stern-shawn/ShawnAndTianshus-EE-748-Capstone/Android Code/Images/Arm Control/up3.png

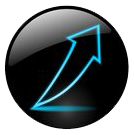
Android Code/Images/Arm Control/up3.png
