stern-shawn/ShawnAndTianshus-EE-748-Capstone/Android Code/Images/voice.png

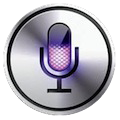
Android Code/Images/voice.png
