stern-shawn/ShawnAndTianshus-EE-748-Capstone/README.md

# ShawnAndTianshus-EE-748-Capstone
Capstone project for EE 478 class. Semi-autonomous robot which could navigate simple mazes, avoid obstacles, grasp objects, and was fully controllable through an android application with additional voice command options over bluetooth
