stern-shawn/ShawnAndTianshus-EE-748-Capstone/Deliverables/Final Project Presentation Slides.pptx

## Mobile Robotic Arm

Tianshu Bao
Shawn Stern
Dan Tran

## The Team – Tianshu Bao

- Major in EE, Embedded System and VLSI
- Previous Hardware Testing Engineer at Cisco
- Software Developer at Expedia
- Traveler

## The Team – Shawn Stern

- Major in EE, Embedded concentration
- Minor in Technical/Business Japanese
- Previously interned at Intel in Santa Clara
- Working full-time at Intel (Aloha, OR) starting July as a PDE
- Part-time head smasher

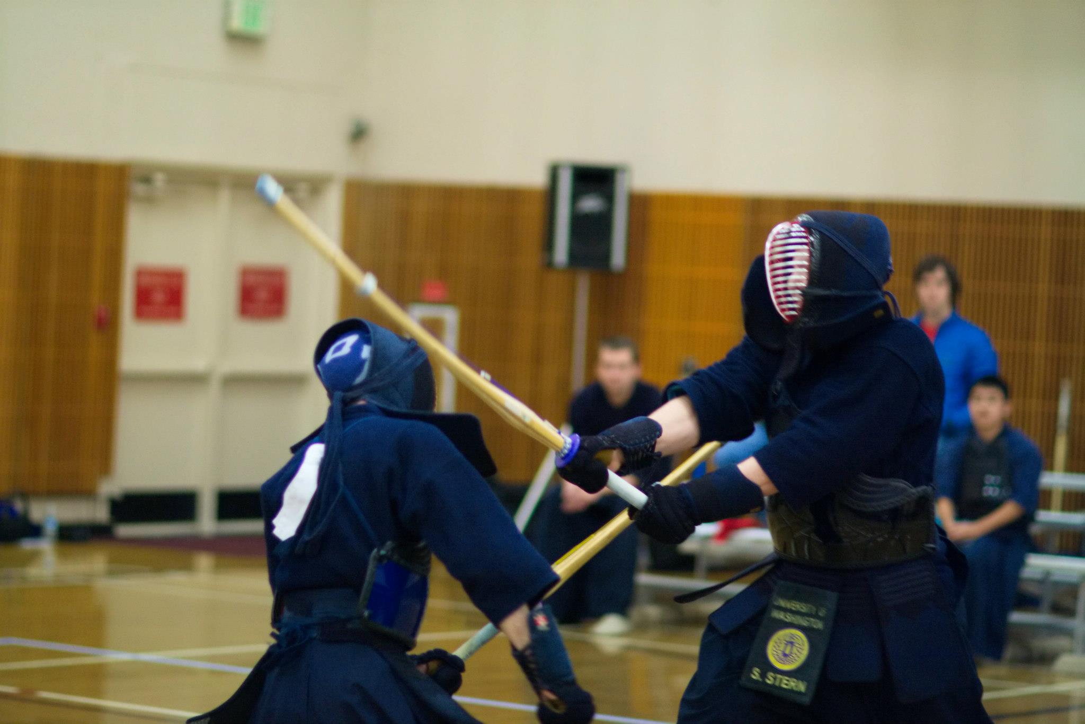
[picture p5: figure]

## The Team – Dan Tran

- Major in EE, Embedded System
- Software Design Engineer in Test – at Spacelabs Healthcare
- Leader at Agape Non-Profit Organization

## Project Objectives

- Create a robotic arm that can manipulate small objects
- Mount the arm on a mobile platform
- Develop an Android application for wireless control
- Implement voice commands for the Android application
- Add safety features and self-control

## Why

- Personal interest in and history with robotics
- Desire to work with a robust, functional microcontroller and sensors of our own choosing
- Curiosity about Android development and working with Google’s APIs
- Challenge of developing scratch-made Arduino libraries and obstacle navigation in Java

## Development Environment

- Arduino Uno
  - PWM Control
  - Serial
  - SPI
  - Digital control
- Android (Java)
  - Serial over Bluetooth
  - Voice recognition
  - Environment navigation

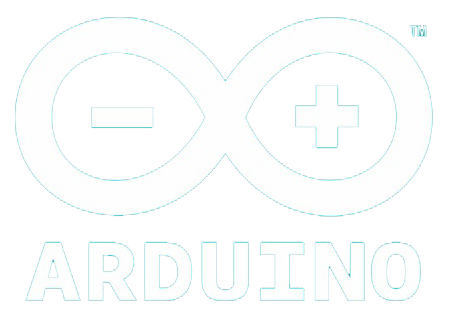
[picture p6: figure]

## Current State

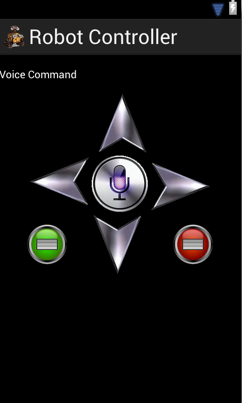
[picture p7: figure]

## Changes and Other Possible Features

- Compliment autonomous navigation with additional sensors to increase functionality
  - Temperature sensing, color and/or shape recognition
- Different arm types for different purposes
  - Cutting tools, fire suppressant, etc.
- Optional video feed for longer-range control

## Difficulties

- Multithreading
- Distance sensor
- Robot speed control
- Servo motors
- No issues with the Arduino itself!

## Questions?
