stern-shawn/ShawnAndTianshus-EE-748-Capstone/Android Code/Images/Arm Control/down.png

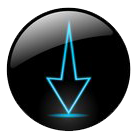
Android Code/Images/Arm Control/down.png
