stern-shawn/ShawnAndTianshus-EE-748-Capstone/Android Code/Images/Arm Control/grasp.png

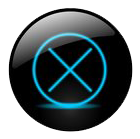
Android Code/Images/Arm Control/grasp.png
