stern-shawn/ShawnAndTianshus-EE-748-Capstone/Android Code/Images/Arm Control/left.png

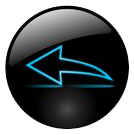
Android Code/Images/Arm Control/left.png
