stern-shawn/ShawnAndTianshus-EE-748-Capstone/Android Code/Images/Arm Control/right.png

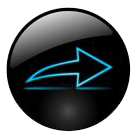
Android Code/Images/Arm Control/right.png
