stern-shawn/ShawnAndTianshus-EE-748-Capstone/Android Code/Images/Arm Control/up2.png

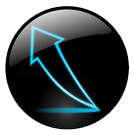
Android Code/Images/Arm Control/up2.png
