stern-shawn/ShawnAndTianshus-EE-748-Capstone/Android Code/Images/brake_button_2.png

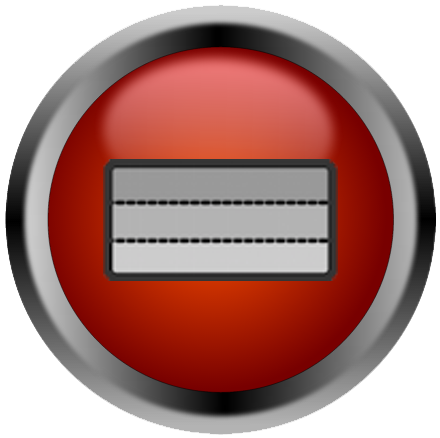
Android Code/Images/brake_button_2.png
