stern-shawn/ShawnAndTianshus-EE-748-Capstone/(commit log)

2016-06-01 Add files via upload
    Commit of arduino sketches to control robot's electrical systems and interface with bluetooth radio to android app
2016-06-01 Add files via upload
    Documentation of non-common electrical devices in project
2016-06-01 Add files via upload
    Project Documentation
    [Bill of Materials.xlsx]
